JimGage/BirthdayCakeKeyboard/3DFiles/10KeyPlate.stl

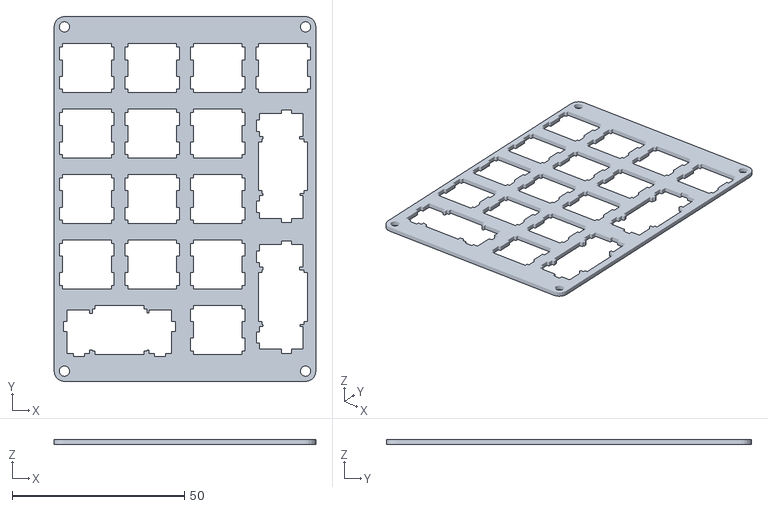
[picture p1: CAD file, 2017-01-08]
3DFiles/10KeyPlate.stl
76.0 x 106.0 x 1.50
