JimGage/BirthdayCakeKeyboard/3DFiles/10KeyBezel.stl

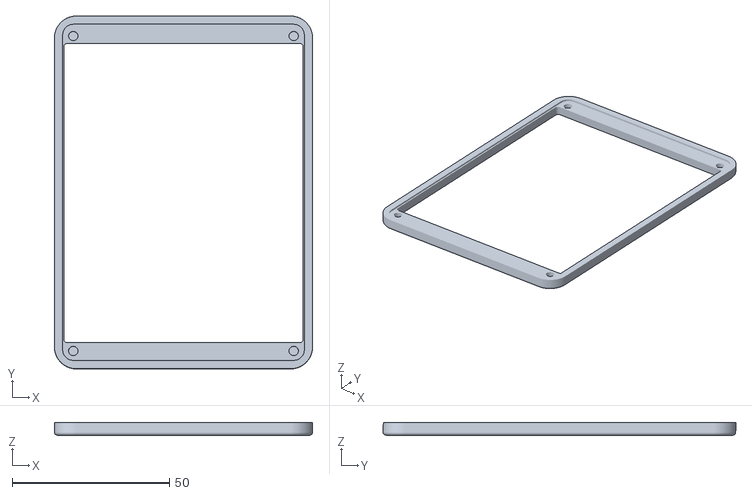
[picture p2: CAD file, 2017-01-08]
3DFiles/10KeyBezel.stl
82.0 x 112.1 x 4.00
