JimGage/BirthdayCakeKeyboard/3DFiles/10KeyBox.stl

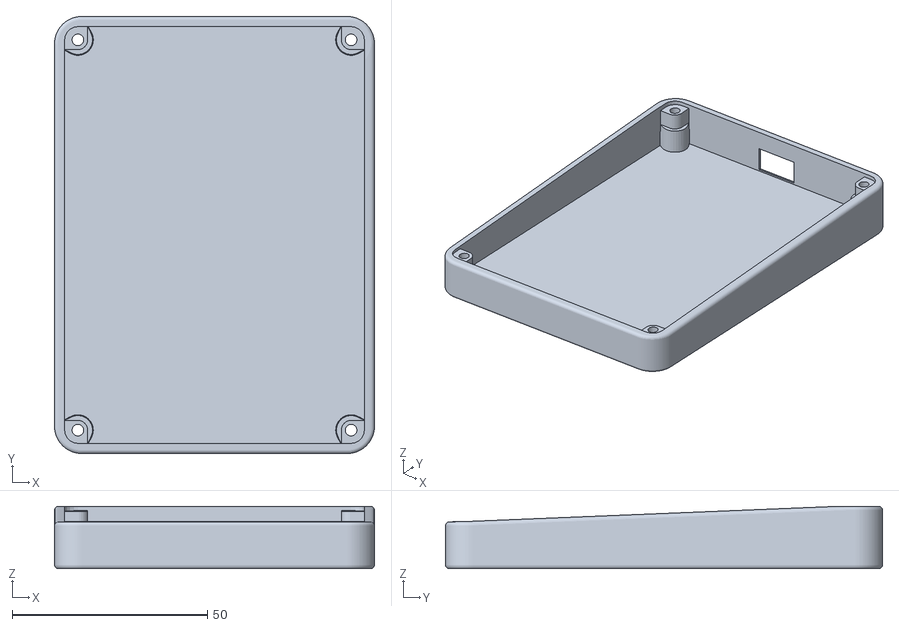
[picture p3: CAD file, 2017-01-08]
3DFiles/10KeyBox.stl
82.0 x 112.0 x 16.0
