JimGage/BirthdayCakeKeyboard/KiCadNoLogo/10Key.kicad_pcb

## KiCad design KiCadNoLogo/10Key.kicad_pcb (2017-01-08)

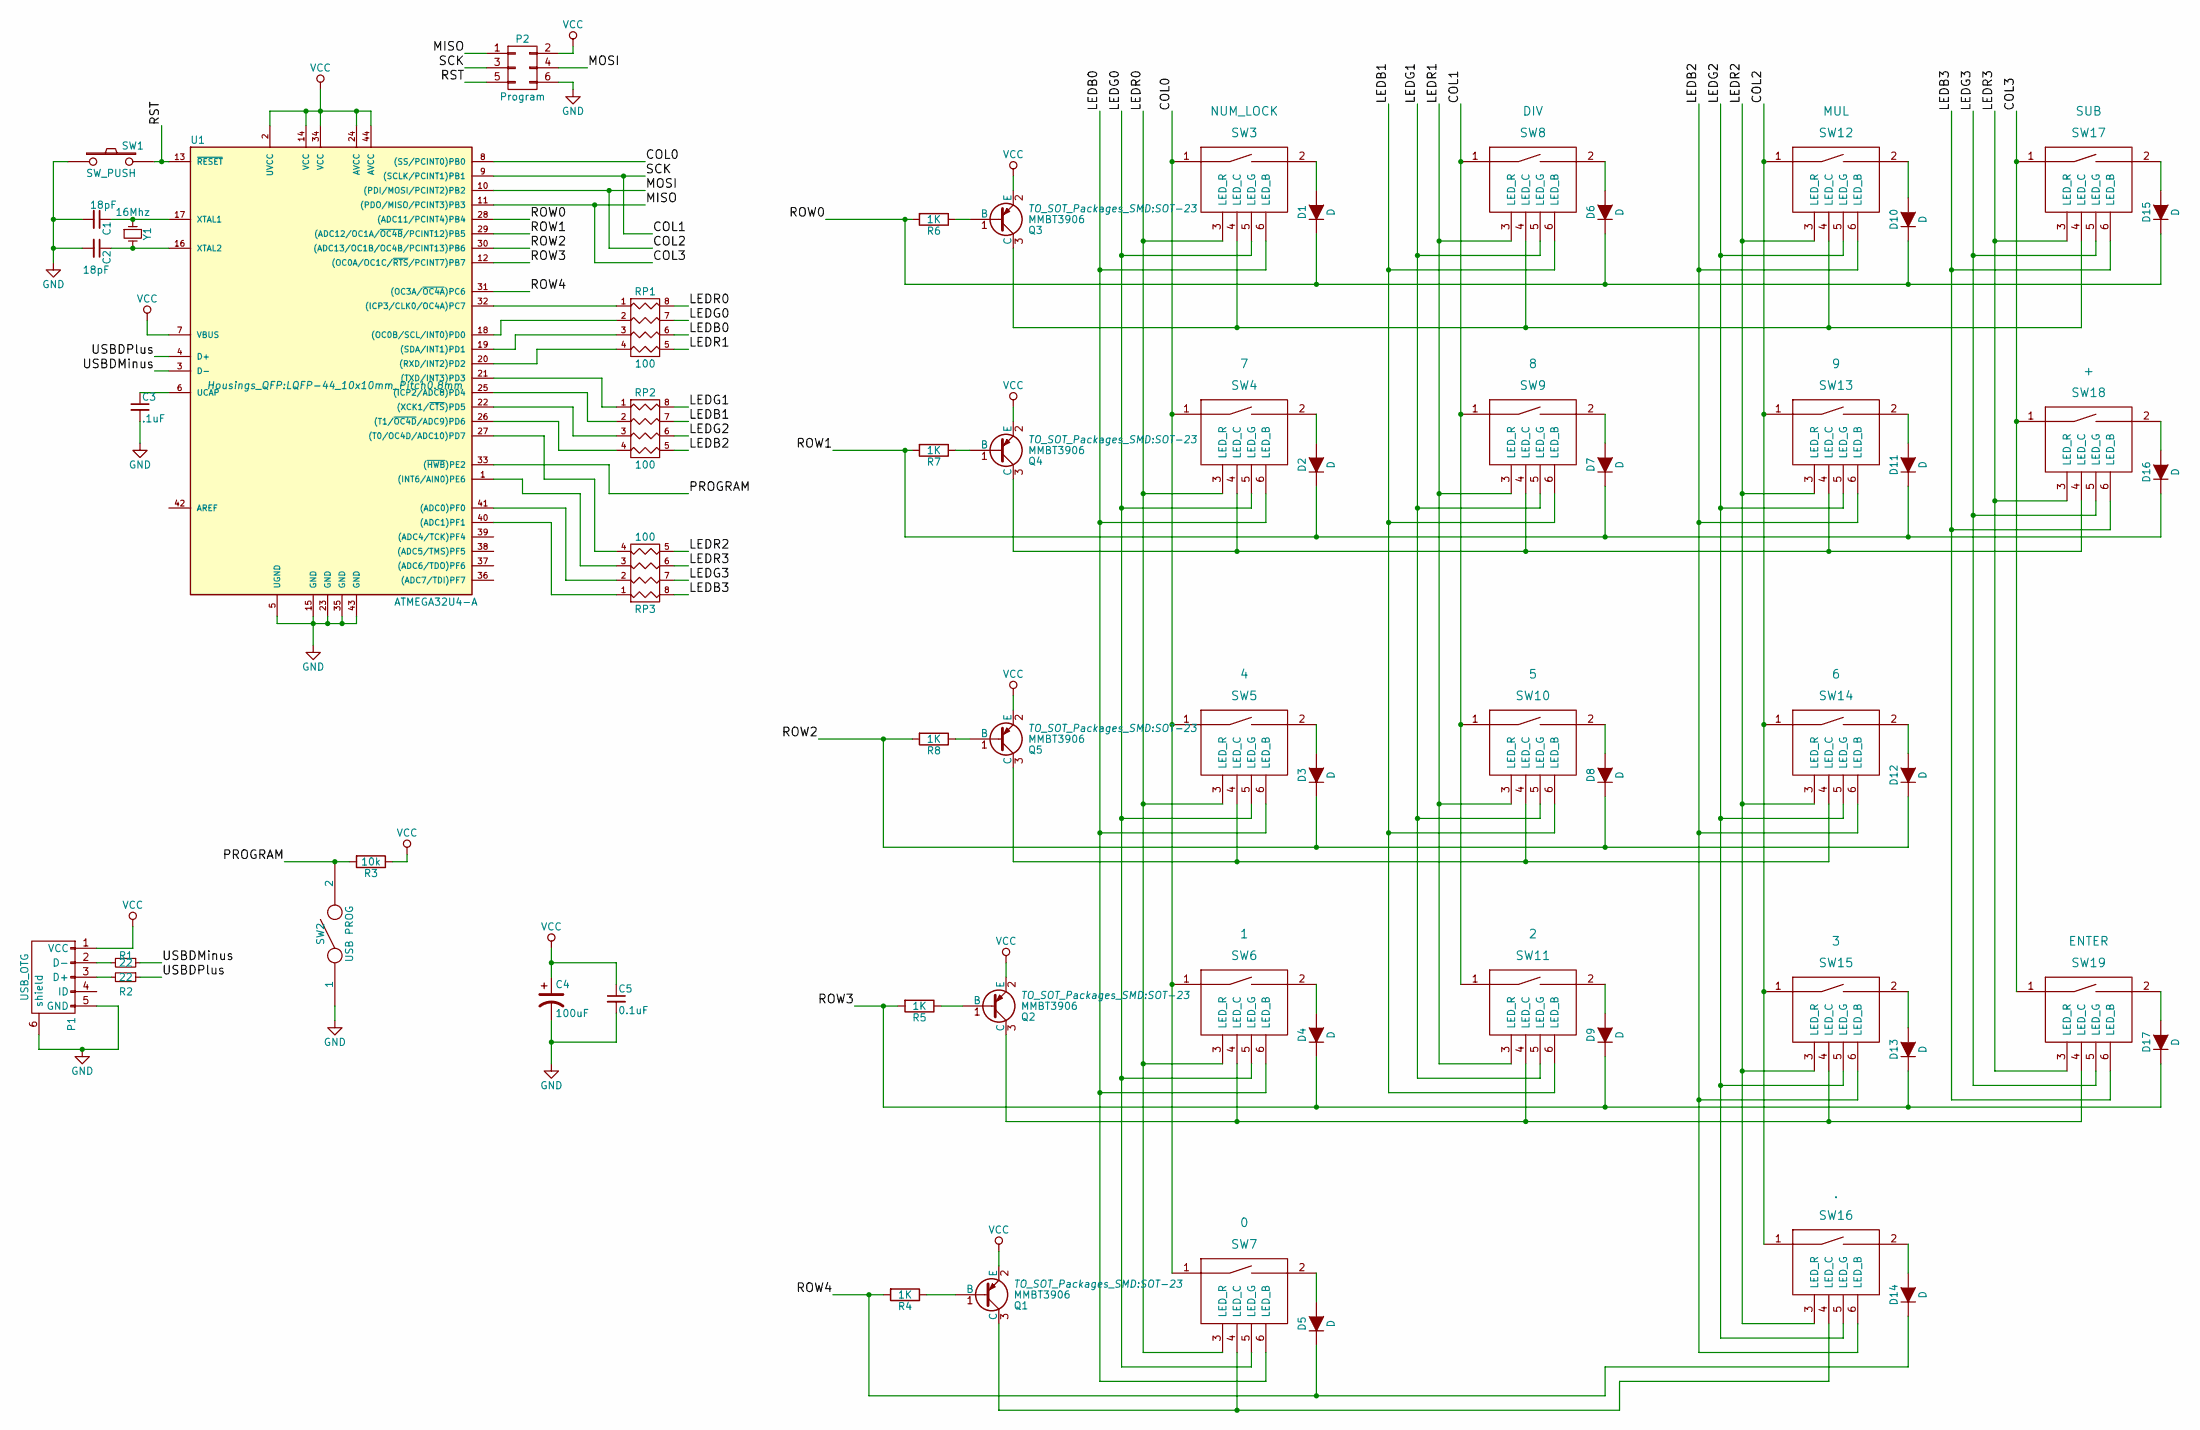
[picture p4: schematic 10Key.sch]

Parts:
C1, C2: 18pF; C_0603_HandSoldering
C3: .1uF; C_0603_HandSoldering
C4: 100uF; SMD-1206_Pol
C5: 0.1uF; C_0603_HandSoldering
D1, D2, D3, D4, D5, D6, D7, D8, D9, D10, D11, D12, D13, D14, D15, D16, D17: D; MiniMELF_Standard
P1: USB_OTG; USB_Micro-B
P2: Program; Pin_Header_Straight_2x03
Q1, Q2, Q3, Q4, Q5: MMBT3906; SOT-23
R1, R2: 22; R_0603_HandSoldering
R3: 10k; R_0603_HandSoldering
R4, R5, R6, R7, R8: 1K; R_0603_HandSoldering
RP1, RP2, RP3: 100; R_Array_Convex_4x1206
SW1: SW_PUSH; SW_SPST_EVQQ2
SW2: USB PROG; SW_SP3T_PCM13
SW3: NUM_LOCK; Zealios_Cherry_MX
SW4: 7; Zealios_Cherry_MX
SW5: 4; Zealios_Cherry_MX
SW6: 1; Zealios_Cherry_MX
SW7: 0; Zealios_Cherry_MX
SW8: DIV; Zealios_Cherry_MX
SW9: 8; Zealios_Cherry_MX
SW10: 5; Zealios_Cherry_MX
SW11: 2; Zealios_Cherry_MX
SW12: MUL; Zealios_Cherry_MX
SW13: 9; Zealios_Cherry_MX
SW14: 6; Zealios_Cherry_MX
SW15: 3; Zealios_Cherry_MX
SW16: .; Zealios_Cherry_MX
SW17: SUB; Zealios_Cherry_MX
SW18: +; Zealios_Cherry_MX
SW19: ENTER; Zealios_Cherry_MX
U1: ATMEGA32U4-A; LQFP-44_10x10mm_Pitch0.8mm
Y1: 16Mhz; Q_49U3HMS

Connections:
/COL0: SW3.1, SW4.1, SW5.1, SW6.1, SW7.1, U1.8 ((SS/PCINT0)PB0)
/COL1: P2.3, SW8.1, SW9.1, SW10.1, SW11.1, U1.9 ((SCLK/PCINT1)PB1)
/COL2: P2.4, SW12.1, SW13.1, SW14.1, SW15.1, SW16.1, U1.10 ((PDI/MOSI/PCINT2)PB2)
/COL3: P2.1, SW17.1, SW18.1, SW19.1, U1.11 ((PDO/MISO/PCINT3)PB3)
/LEDB0: RP1.6 (R3), SW3.6 (LED_B), SW4.6 (LED_B), SW5.6 (LED_B), SW6.6 (LED_B), SW7.6 (LED_B)
/LEDB1: RP2.7 (R2), SW8.6 (LED_B), SW9.6 (LED_B), SW10.6 (LED_B), SW11.6 (LED_B)
/LEDB2: RP2.5 (R4), SW12.6 (LED_B), SW13.6 (LED_B), SW14.6 (LED_B), SW15.6 (LED_B), SW16.6 (LED_B)
/LEDB3: RP3.8 (R1), SW17.6 (LED_B), SW18.6 (LED_B), SW19.6 (LED_B)
/LEDG0: RP1.7 (R2), SW3.5 (LED_G), SW4.5 (LED_G), SW5.5 (LED_G), SW6.5 (LED_G), SW7.5 (LED_G)
/LEDG1: RP2.8 (R1), SW8.5 (LED_G), SW9.5 (LED_G), SW10.5 (LED_G), SW11.5 (LED_G)
/LEDG2: RP2.6 (R3), SW12.5 (LED_G), SW13.5 (LED_G), SW14.5 (LED_G), SW15.5 (LED_G), SW16.5 (LED_G)
/LEDG3: RP3.7 (R2), SW17.5 (LED_G), SW18.5 (LED_G), SW19.5 (LED_G)
/LEDR0: RP1.8 (R1), SW3.3 (LED_R), SW4.3 (LED_R), SW5.3 (LED_R), SW6.3 (LED_R), SW7.3 (LED_R)
/LEDR1: RP1.5 (R4), SW8.3 (LED_R), SW9.3 (LED_R), SW10.3 (LED_R), SW11.3 (LED_R)
/LEDR2: RP3.5 (R4), SW12.3 (LED_R), SW13.3 (LED_R), SW14.3 (LED_R), SW15.3 (LED_R), SW16.3 (LED_R)
/LEDR3: RP3.6 (R3), SW17.3 (LED_R), SW18.3 (LED_R), SW19.3 (LED_R)
/PROGRAM: R3.2, SW2.2, U1.33 ((~HWB~)PE2)
/ROW0: D1.1 (K), D6.1 (K), D10.1 (K), D15.1 (K), R6.2, U1.28 ((ADC11/PCINT4)PB4)
/ROW1: D2.1 (K), D7.1 (K), D11.1 (K), D16.1 (K), R7.2, U1.29 ((ADC12/OC1A/~OC4B~/PCINT12)PB5)
/ROW2: D3.1 (K), D8.1 (K), D12.1 (K), R8.2, U1.30 ((ADC13/OC1B/OC4B/PCINT13)PB6)
/ROW3: D4.1 (K), D9.1 (K), D13.1 (K), D17.1 (K), R5.2, U1.12 ((OC0A/OC1C/~RTS~/PCINT7)PB7)
/ROW4: D5.1 (K), D14.1 (K), R4.2, U1.31 ((OC3A/~OC4A~)PC6)
/RST: P2.5, SW1.2, U1.13 (~RESET~)
/USBDMinus: R1.1, U1.3 (D-)
/USBDPlus: R2.1, U1.4 (D+)
GND: C1.2, C2.2, C3.2, C4.2, C5.2, P1.5 (GND), P1.6 (shield), P2.6, SW1.1, SW2.1, U1.5 (UGND), U1.15 (GND), U1.23 (GND), U1.35 (GND), U1.43 (GND)
unnamed: C1.1, U1.17 (XTAL1), Y1.1
unnamed: C2.1, U1.16 (XTAL2), Y1.2
unnamed: C3.1, U1.6 (UCAP)
unnamed: D1.2 (A), SW3.2
unnamed: D2.2 (A), SW4.2
unnamed: D3.2 (A), SW5.2
unnamed: D4.2 (A), SW6.2
unnamed: D5.2 (A), SW7.2
unnamed: D6.2 (A), SW8.2
unnamed: D7.2 (A), SW9.2
unnamed: D8.2 (A), SW10.2
unnamed: D9.2 (A), SW11.2
unnamed: D10.2 (A), SW12.2
unnamed: D11.2 (A), SW13.2
unnamed: D12.2 (A), SW14.2
unnamed: D13.2 (A), SW15.2
unnamed: D14.2 (A), SW16.2
unnamed: D15.2 (A), SW17.2
unnamed: D16.2 (A), SW18.2
unnamed: D17.2 (A), SW19.2
unnamed: P1.2 (D-), R1.2
unnamed: P1.3 (D+), R2.2
unnamed: Q1.1 (B), R4.1
unnamed: Q1.3 (C), SW7.4 (LED_C), SW16.4 (LED_C)
unnamed: Q2.1 (B), R5.1
unnamed: Q2.3 (C), SW6.4 (LED_C), SW11.4 (LED_C), SW15.4 (LED_C), SW19.4 (LED_C)
unnamed: Q3.1 (B), R6.1
unnamed: Q3.3 (C), SW3.4 (LED_C), SW8.4 (LED_C), SW12.4 (LED_C), SW17.4 (LED_C)
unnamed: Q4.1 (B), R7.1
unnamed: Q4.3 (C), SW4.4 (LED_C), SW9.4 (LED_C), SW13.4 (LED_C), SW18.4 (LED_C)
unnamed: Q5.1 (B), R8.1
unnamed: Q5.3 (C), SW5.4 (LED_C), SW10.4 (LED_C), SW14.4 (LED_C)
unnamed: RP1.1, U1.32 ((ICP3/CLK0/OC4A)PC7)
unnamed: RP1.2, U1.18 ((OC0B/SCL/INT0)PD0)
unnamed: RP1.3, U1.19 ((SDA/INT1)PD1)
unnamed: RP1.4, U1.20 ((RXD/INT2)PD2)
unnamed: RP2.1, U1.21 ((TXD/INT3)PD3)
unnamed: RP2.2, U1.25 ((ICP2/ADC8)PD4)
unnamed: RP2.3, U1.22 ((XCK1/~CTS~)PD5)
unnamed: RP2.4, U1.26 ((T1/~OC4D~/ADC9)PD6)
unnamed: RP3.1, U1.40 ((ADC1)PF1)
unnamed: RP3.2, U1.41 ((ADC0)PF0)
unnamed: RP3.3, U1.1 ((INT6/AIN0)PE6)
unnamed: RP3.4, U1.27 ((T0/OC4D/ADC10)PD7)
VCC: C4.1, C5.1, P1.1 (VCC), P2.2, Q1.2 (E), Q2.2 (E), Q3.2 (E), Q4.2 (E), Q5.2 (E), R3.1, U1.2 (UVCC), U1.7 (VBUS), U1.14 (VCC), U1.24 (AVCC), U1.34 (VCC), U1.44 (AVCC)

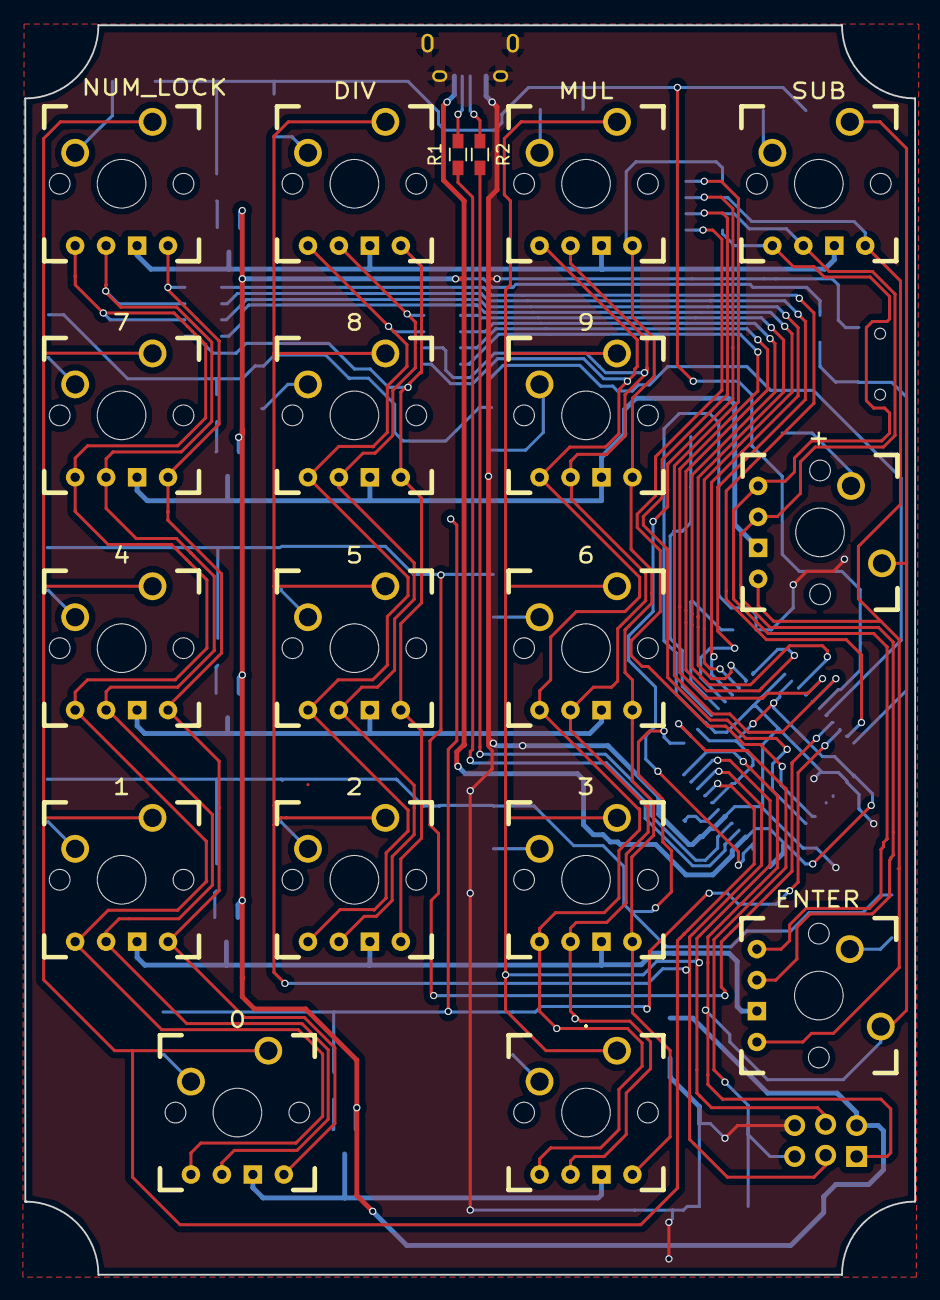
[picture p5: board 10Key.kicad_pcb from above]

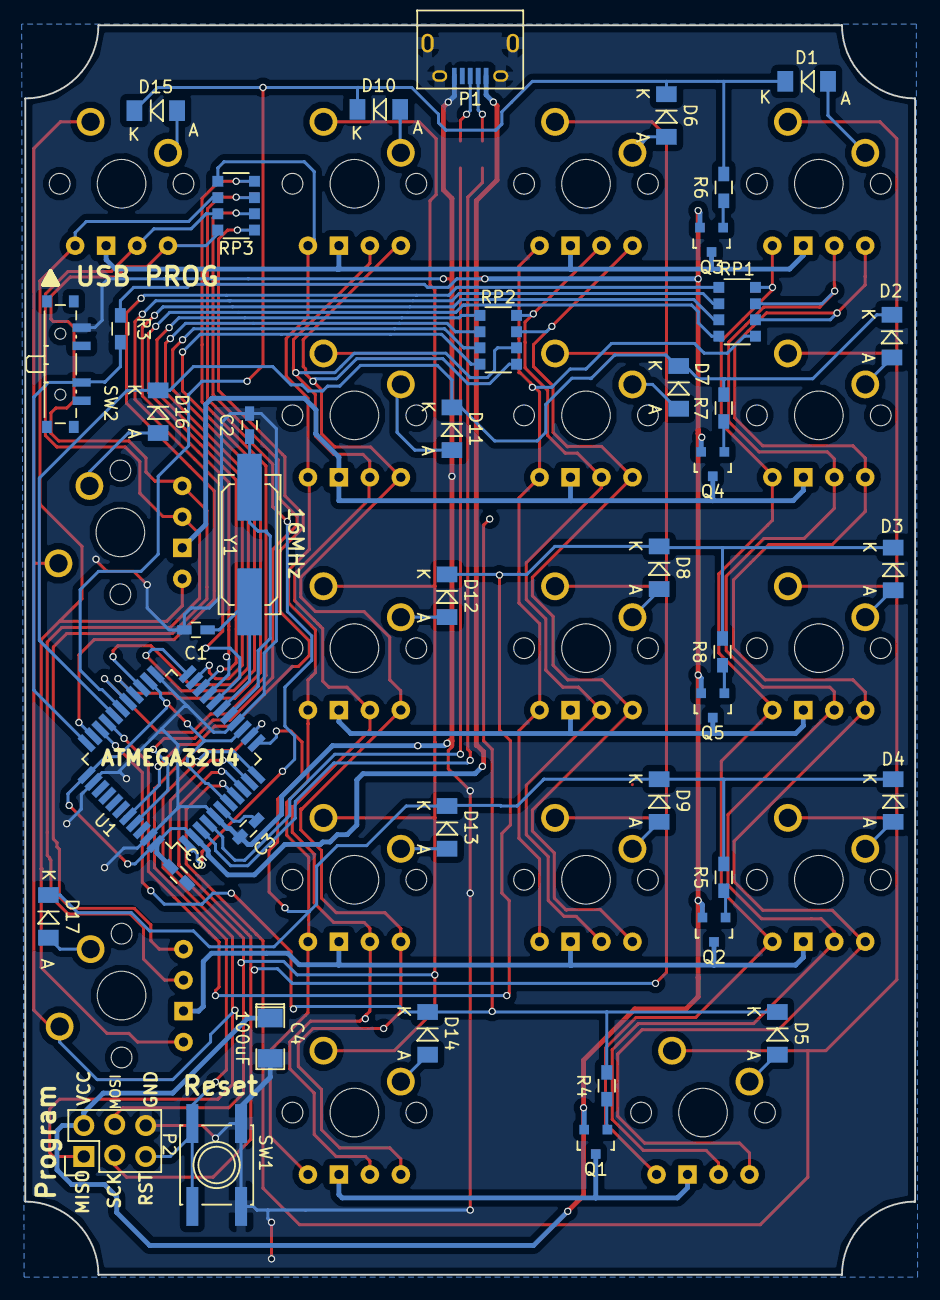
[picture p6: board 10Key.kicad_pcb from below]

Board: 2 copper layers, 73.0 x 102.5 mm, 61 parts (42 on the bottom side), 71 nets.
