JimGage/BirthdayCakeKeyboard/(commit log)

2016-08-02 Adding a version of the PCB with no logo.
    [10Key-B.Cu.gbl, 10Key-B.Mask.gbs, 10Key-B.SilkS.gbo, 10Key-Edge.Cuts.gm1, 10Key-F.Cu.gtl, 10Key-F.Mask.gts, 10Key-F.SilkS.gto, 10Key.drl]
2016-08-02 Created parts list
    This is currently my best guess on parts used. A few parts I pulled from my parts drawer had no labels.
2016-08-09 * Added extra capacitance * Added current limiting resistors * Moved connections off of the jtag pins so that an external programmer * will not be needed to set fuses.
    [10Key.kicad_pcb, 10Key.sch]
2016-09-18 Updated no logo pcb with current limiting resistors.
    [10Key.kicad_pcb, 10Key.sch]
2017-01-08 Added current limiting resistors.
    A bunch of clean up. Added current limiting resistors. Moved a number of connections off of the JTAG pins so that they don't need to have fuses reconfigured.
    [10Key.kicad_pcb, 10Key.sch]
2017-01-08 Reconfigured pins.
    Some pins have been moved so that they don't rely on the JTAG pins which require the fuses to be updated. Can now be updated through the initial firmware updater.
2017-01-08 Added top bezel
    Added a bezel for the top and made the box a little bit deeper.
    [10Key.scad, 10KeyBezel.stl, 10KeyBox.stl, 10KeyPlate.stl]
